wlowi/UselessBox/doc/DSC_9165.JPG

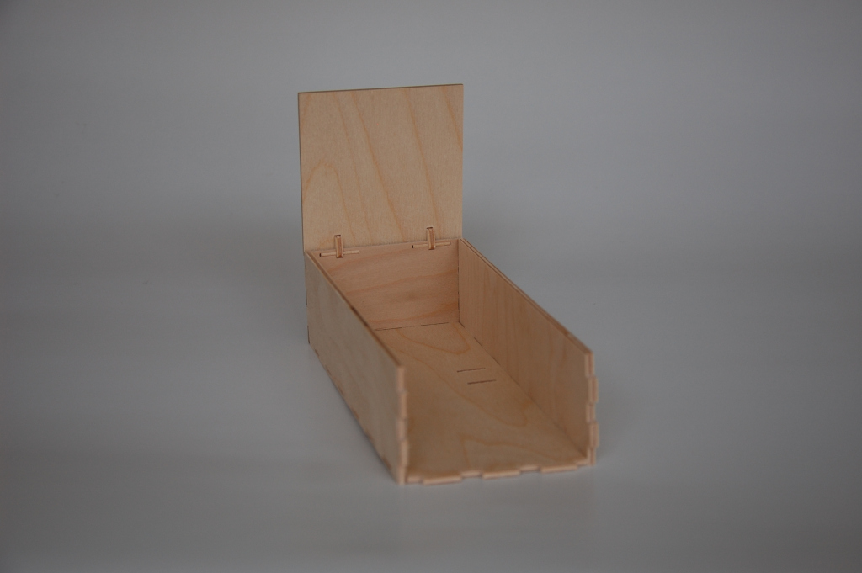
doc/DSC_9165.JPG
