wlowi/UselessBox/doc/DSC_9166.JPG

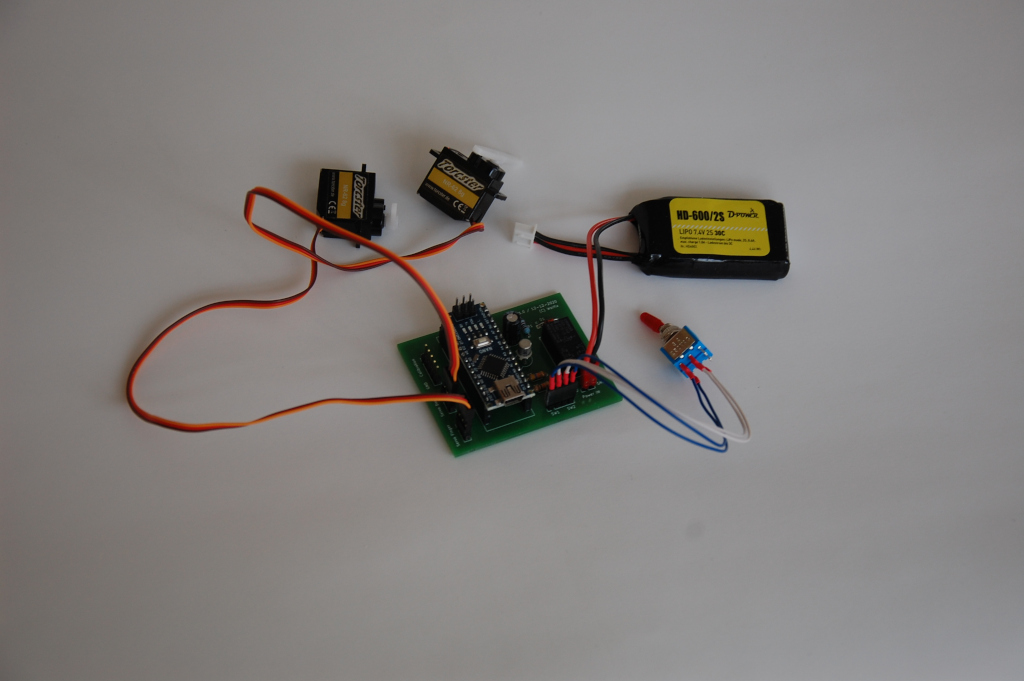
doc/DSC_9166.JPG
