wlowi/UselessBox/README.md

# A useless box.

Arduino code: UselessBox/UselexxBox.ino

Aufbauanleitung: doc/UselessBox.pdf

Fräsdatei: dxf/UselessBox.dxf

KiCAD Schaltplan und Platinenlayout: KiCAD/UselessBox
