wlowi/UselessBox/doc/DSC_9167.JPG

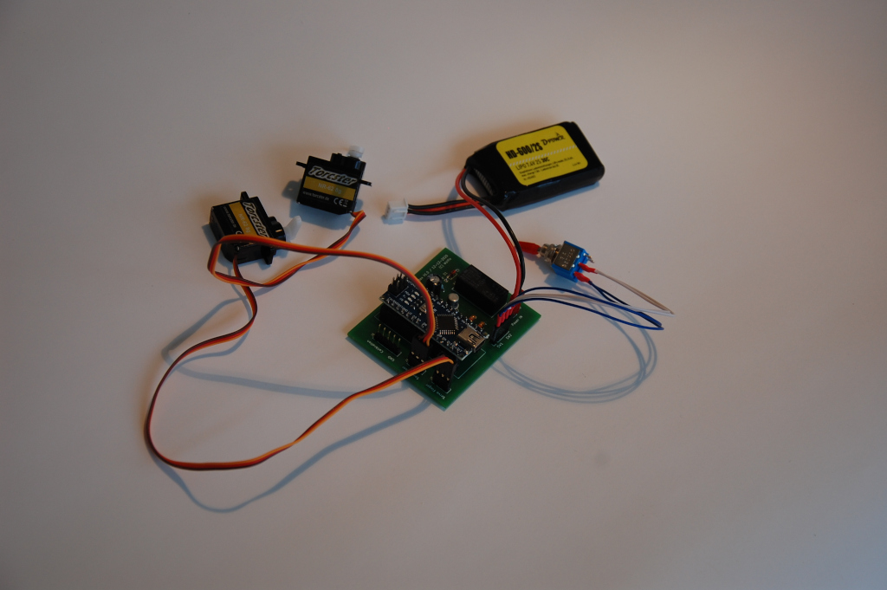
doc/DSC_9167.JPG
