wlowi/UselessBox/doc/DSC_9170.JPG

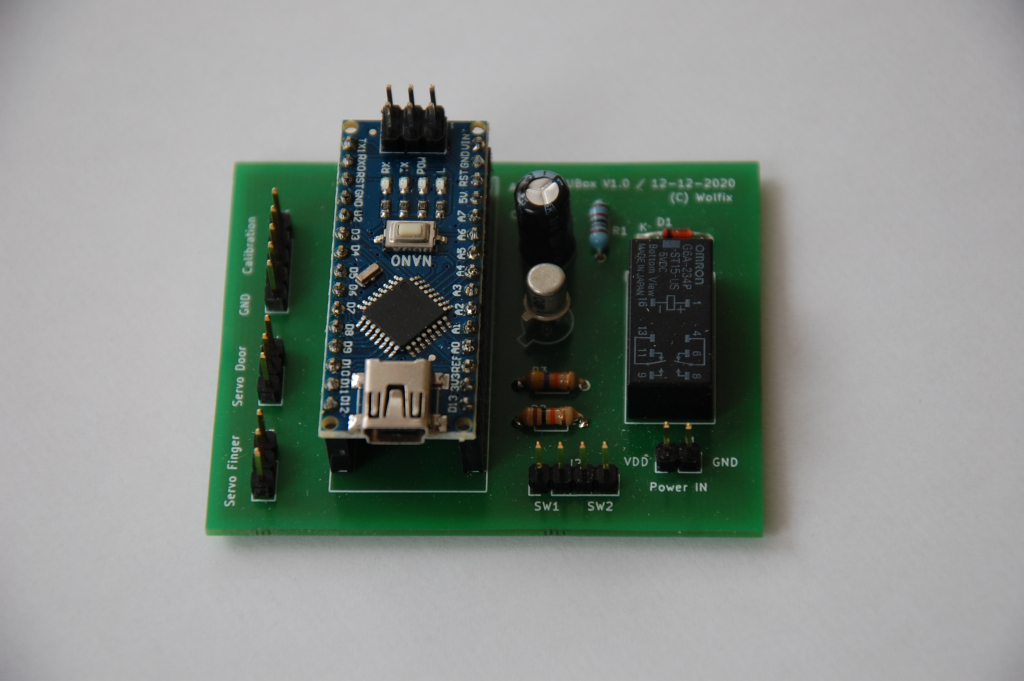
doc/DSC_9170.JPG
