wlowi/UselessBox/doc/NI7_3773.JPG

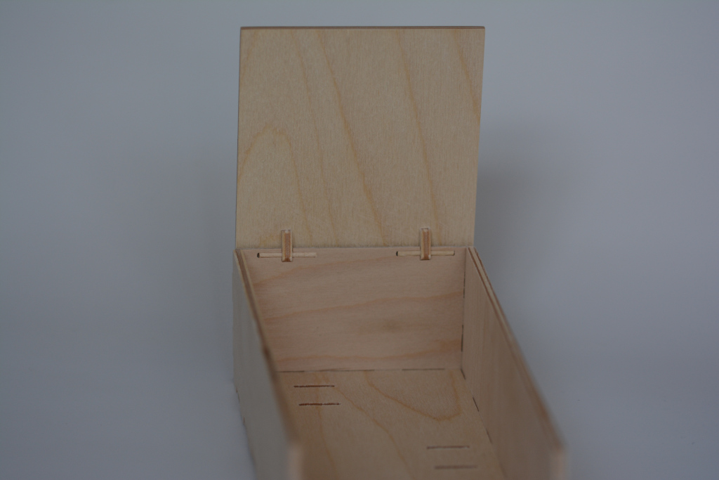
doc/NI7_3773.JPG
