wlowi/UselessBox/doc/NI7_3776.JPG

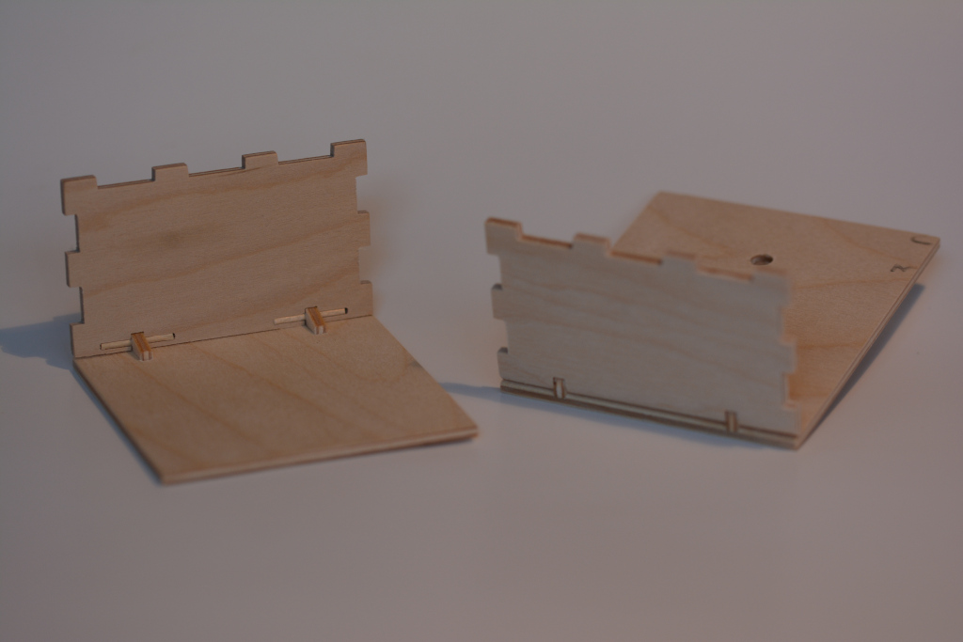
doc/NI7_3776.JPG
