wlowi/UselessBox/KiCAD/UselessBox/PCB_Back.png

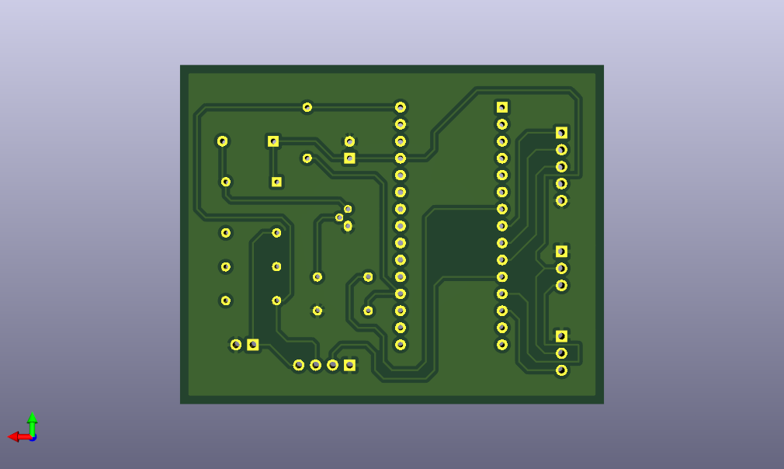
KiCAD/UselessBox/PCB_Back.png
