wlowi/UselessBox/KiCAD/UselessBox/PCB_Front.png

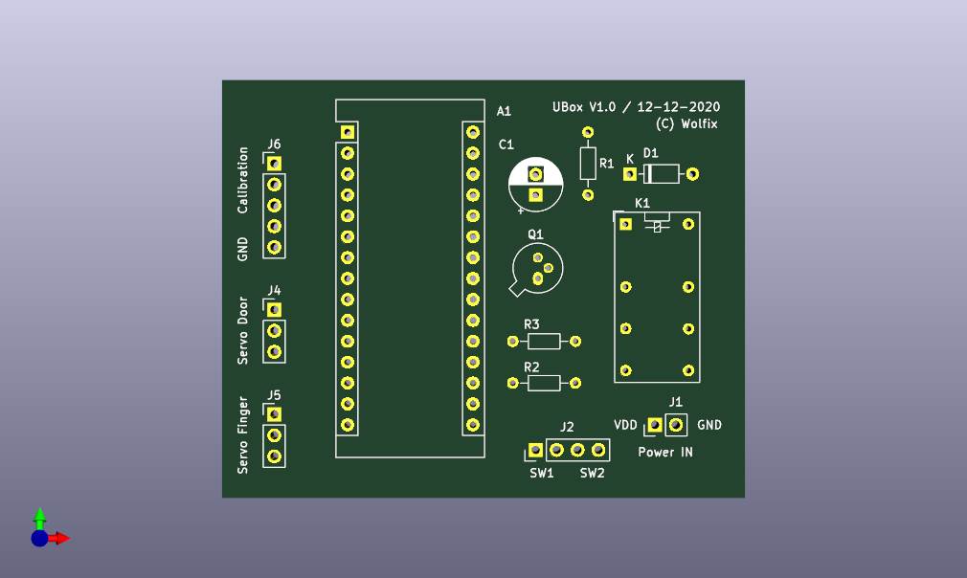
KiCAD/UselessBox/PCB_Front.png
