wlowi/UselessBox/(list of files, cad)

Other CAD files:
dxf/UselessBox.dxf
