wlowi/UselessBox/KiCAD/UselessBox/UselessBox.pdf

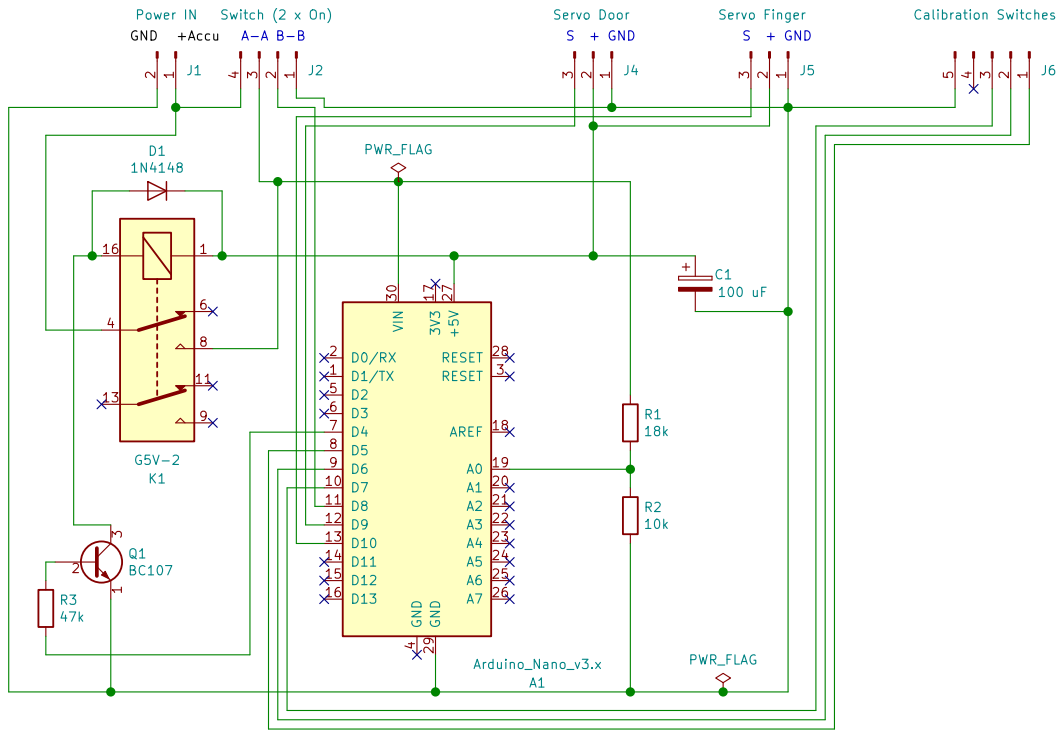
[picture p13: page 1]

Id: 1/1 Title: File: UselessBox.sch Sheet: /
