wlowi/UselessBox/KiCAD/UselessBox/UselessBox.kicad_pcb

## KiCad design KiCAD/UselessBox/UselessBox.kicad_pcb (2020-12-29)

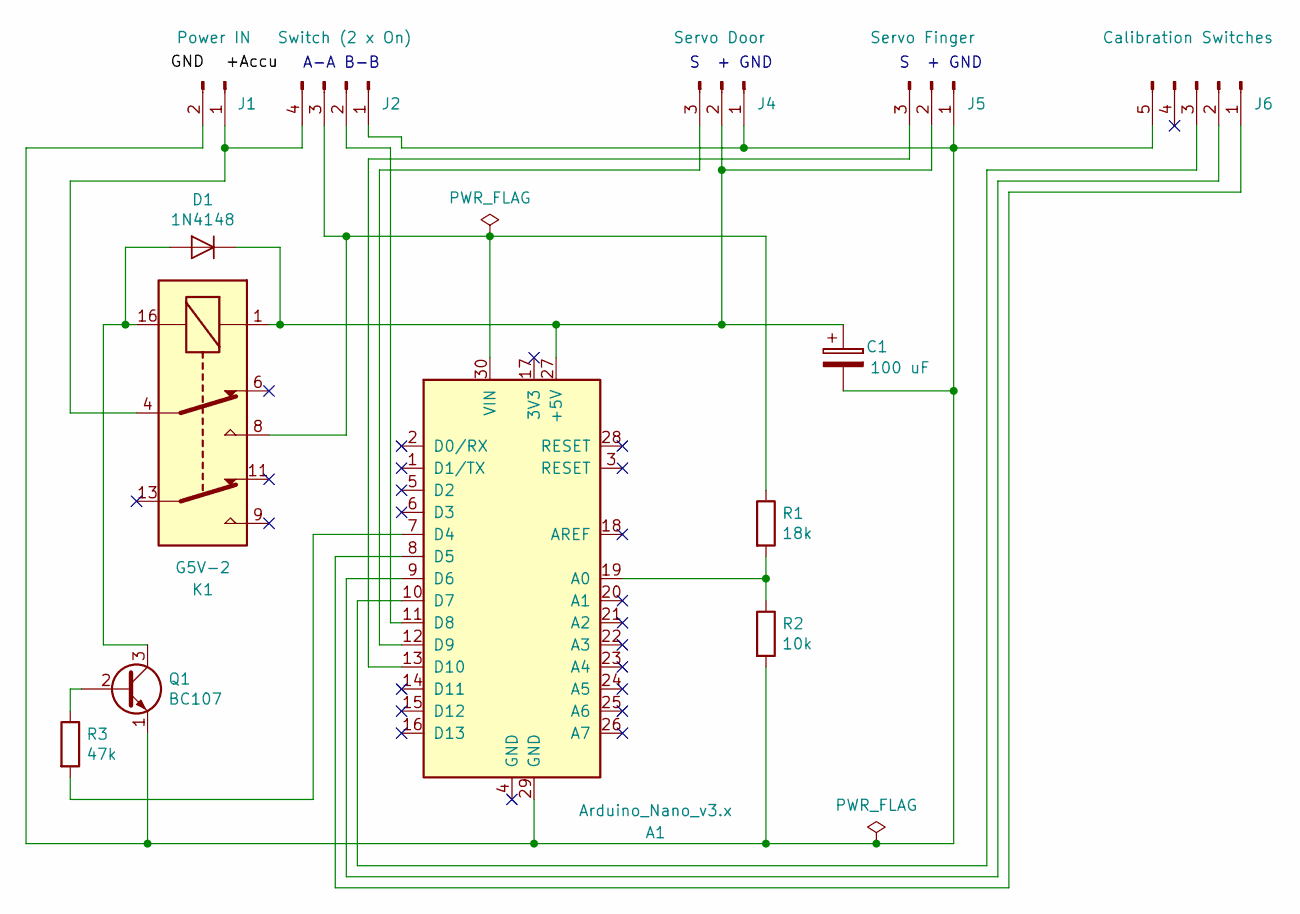
[picture p14: schematic UselessBox.sch]

Parts:
A1: Arduino_Nano_v3.x; Arduino_Nano
C1: 100 uF; CP_Radial_D6.3mm_P2.50mm
D1: 1N4148; D_DO-35_SOD27_P7.62mm_Horizontal
J1: Power IN; PinHeader_1x02_P2.54mm_Vertical
J2: Switch (2 x On); PinHeader_1x04_P2.54mm_Vertical
J4: Servo Door; PinHeader_1x03_P2.54mm_Vertical
J5: Servo Finger; PinHeader_1x03_P2.54mm_Vertical
J6: Calibration Switches; PinHeader_1x05_P2.54mm_Vertical
K1: G5V-2; Relay_DPDT_Omron_G5V-2
Q1: BC107; TO-18-3
R1: 18k; R_Axial_DIN0204_L3.6mm_D1.6mm_P7.62mm_Horizontal
R2: 10k; R_Axial_DIN0204_L3.6mm_D1.6mm_P7.62mm_Horizontal
R3: 47k; R_Axial_DIN0204_L3.6mm_D1.6mm_P7.62mm_Horizontal

Connections:
unnamed: A1.7 (D4), R3.2
unnamed: A1.8 (D5), J6.1
unnamed: A1.9 (D6), J6.2
unnamed: A1.10 (D7), J6.3
unnamed: A1.11 (D8), J2.2
unnamed: A1.12 (D9), J4.3
unnamed: A1.13 (D10), J5.3
unnamed: A1.19 (A0), R1.2, R2.1
unnamed: A1.27 (+5V), C1.1, D1.1 (K), J4.2, J5.2, K1.1
unnamed: A1.29 (GND), C1.2, J1.2, J2.1, J4.1, J5.1, J6.5, Q1.1 (E), R2.2
unnamed: A1.30 (VIN), J2.3, K1.8, R1.1
unnamed: D1.2 (A), K1.16, Q1.3 (C)
unnamed: J1.1, J2.4, K1.4
unnamed: Q1.2 (B), R3.1

Notes on the sheet:
A-A B-B
S + GND

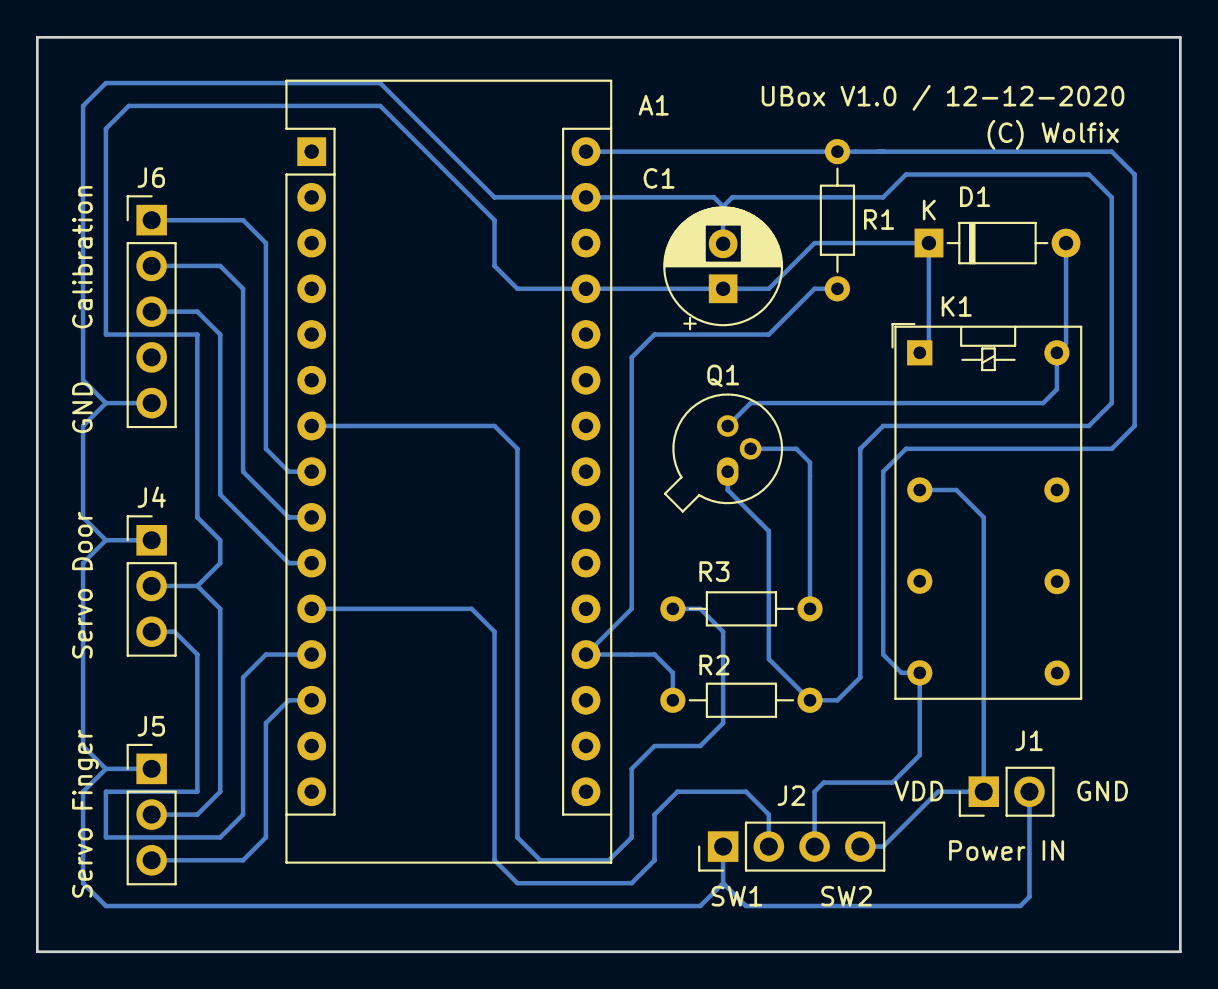
[picture p15: board UselessBox.kicad_pcb from above]

Board: 2 copper layers, 63.5 x 50.8 mm, 13 parts (0 on the bottom side), 14 nets.
