wlowi/UselessBox/(commit log)

2020-12-05 New servo frame time hangling. Immediate response.
2020-12-11 Added KiCAD
    [UselessBox.fzz, UselessBox.kicad_pcb, UselessBox.sch]
2020-12-12 PCB completed
    [UselessBox-B_Cu.gbr, UselessBox-Edge_Cuts.gbr, UselessBox-F_CrtYd.gbr, UselessBox-F_Cu.gbr, UselessBox-F_Fab.gbr, UselessBox-F_Mask.gbr, UselessBox-F_Paste.gbr, UselessBox-F_SilkS.gbr]
2020-12-13 Double check and minor fixes
    [UselessBox-B_Cu.gbr, UselessBox-Edge_Cuts.gbr, UselessBox-F_CrtYd.gbr, UselessBox-F_Cu.gbr, UselessBox-F_Fab.gbr, UselessBox-F_Mask.gbr, UselessBox-F_SilkS.gbr, UselessBox-NPTH.drl]
2020-12-18 Correct back mask on PCB
    [UselessBox.kicad_pcb]
2020-12-19 Low battery monitor.
2020-12-29 Sanitize servo positions. Add PCB images and schema PDF
    [UselessBox-B_Cu.gbr, UselessBox-Edge_Cuts.gbr, UselessBox-F_CrtYd.gbr, UselessBox-F_Cu.gbr, UselessBox-F_Fab.gbr, UselessBox-F_Mask.gbr, UselessBox-F_Paste.gbr, UselessBox-F_SilkS.gbr]
2021-01-11 Better response to calibration request
2022-12-29 Documentation and dxf added.
    [UselessBox.dxf]
